pestalella/Borinot/README.md

# Borinot
Sensor de temperatura i humitat, que envia les dades que recull a una base de dades via WiFi
