pestalella/Borinot/Design/pcb_design.FCStd

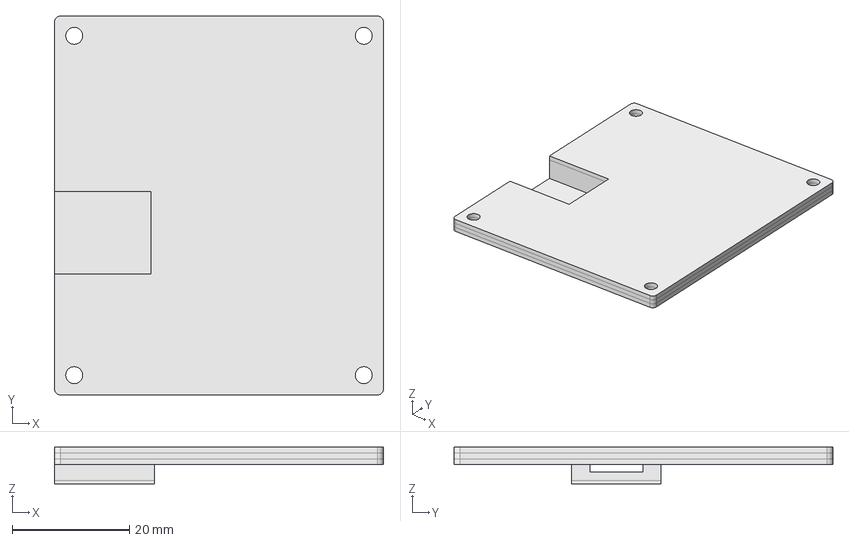
[picture p1: CAD file, 2023-03-15]
Design/pcb_design.FCStd
56.2 x 64.7 x 6.30 mm
