pestalella/Borinot/Design/pcb_design-Box.stl

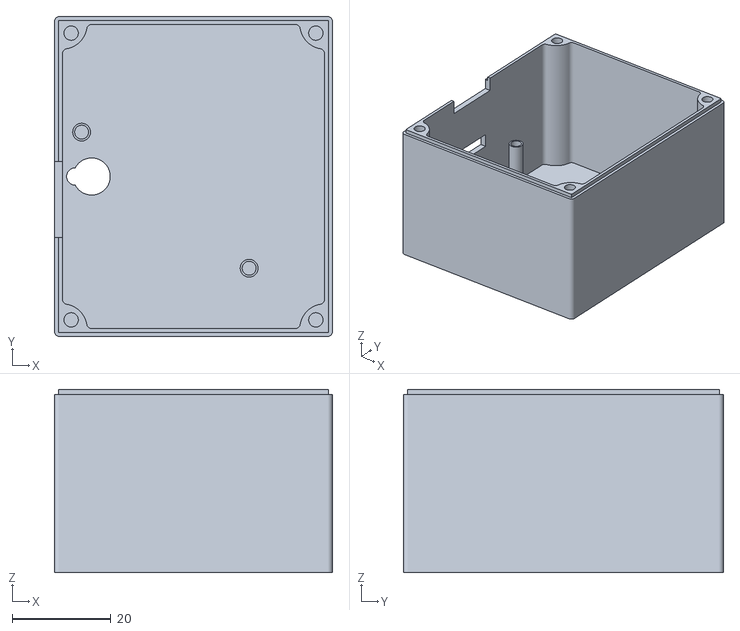
[picture p2: CAD file, 2023-03-15]
Design/pcb_design-Box.stl
56.2 x 64.7 x 37.0
