pestalella/Borinot/(list of files, cad)

Other CAD files:
Design/pcb_design-Lid.stl
