pestalella/Borinot/PCB/Borinot/Borinot.kicad_pcb

## KiCad design PCB/Borinot/Borinot.kicad_pcb (2023-05-26)

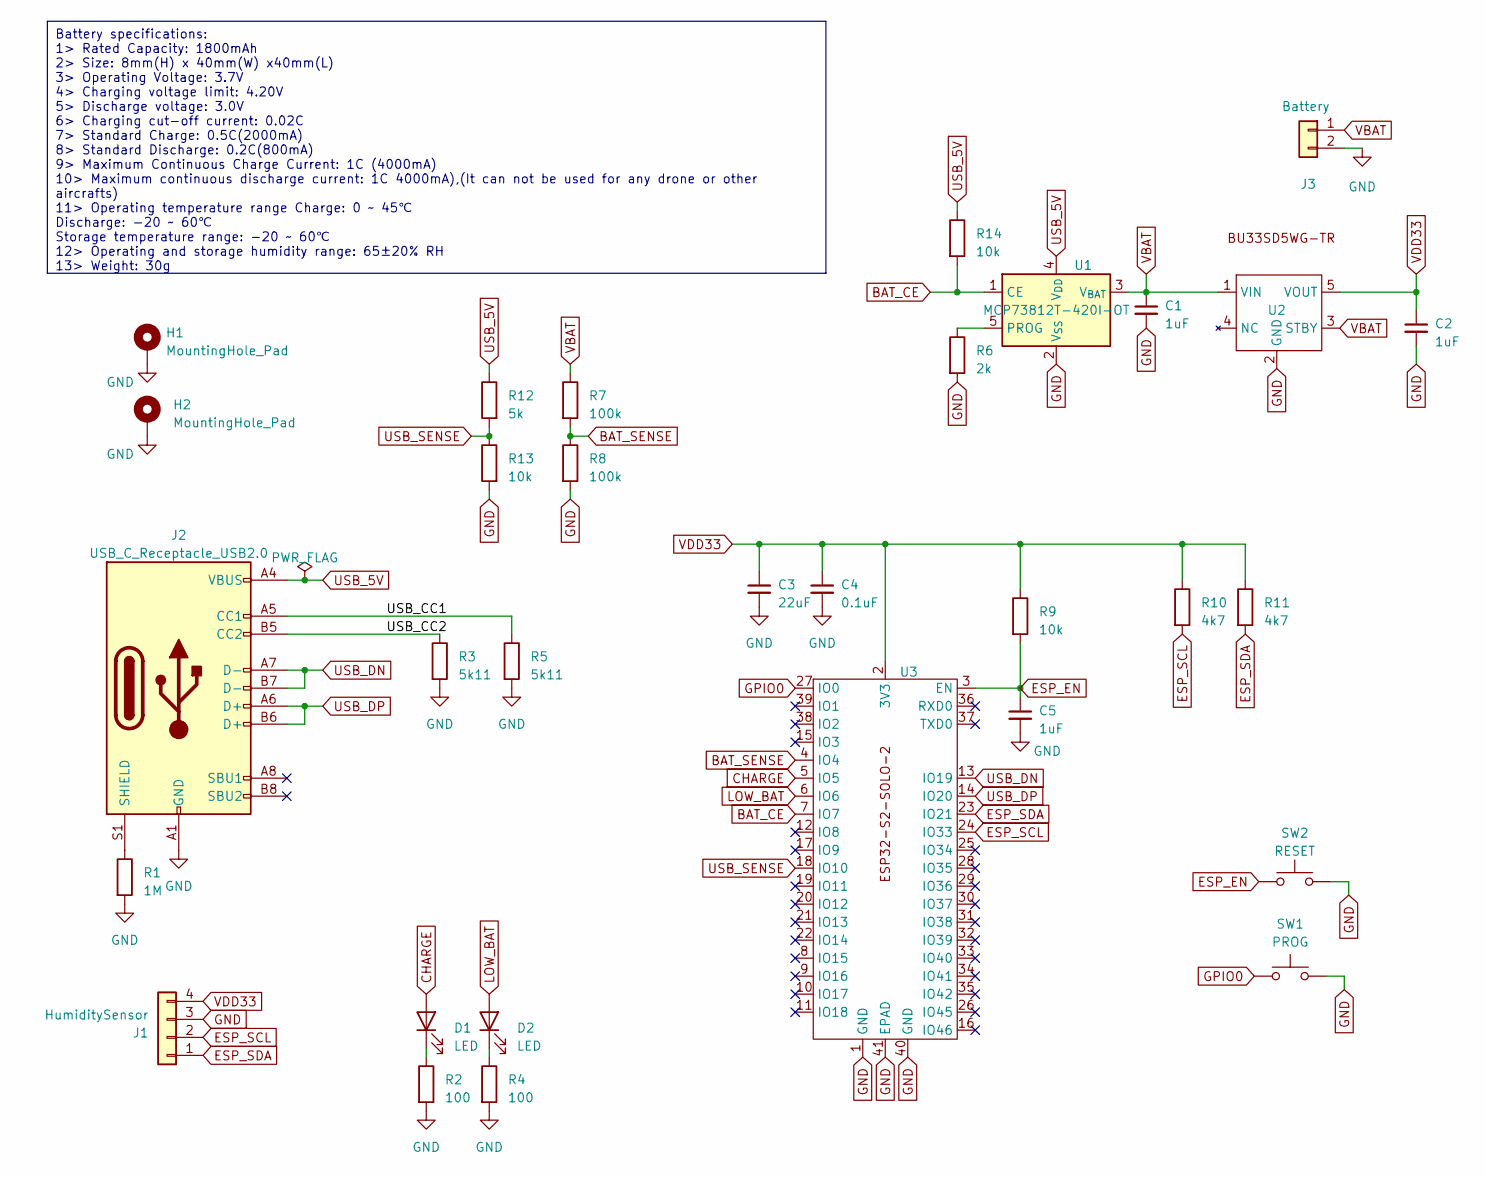
[picture p3: schematic Borinot.kicad_sch]

Parts:
C1, C2, C5: 1uF; C_0805_2012Metric_Pad1.18x1.45mm_HandSolder
C3: 22uF; C_0805_2012Metric_Pad1.18x1.45mm_HandSolder
C4: 0.1uF; C_0805_2012Metric_Pad1.18x1.45mm_HandSolder
D1, D2: LED; LED_0805_2012Metric
H1, H2: MountingHole_Pad; MountingHole_3.2mm_M3_Pad_Via
J1: HumiditySensor; Molex_KK-254_AE-6410-04A_1x04_P2.54mm_Vertical
J2: USB_C_Receptacle_USB2.0; USB_C_Receptacle_G-Switch_GT-USB-7010ASV
J3: Battery; PinHeader_1x02_P2.54mm_Vertical
R1: 1M; R_0805_2012Metric_Pad1.20x1.40mm_HandSolder
R2, R4: 100; R_0805_2012Metric_Pad1.20x1.40mm_HandSolder
R3, R5: 5k11; R_0805_2012Metric_Pad1.20x1.40mm_HandSolder
R6: 2k; R_0805_2012Metric_Pad1.20x1.40mm_HandSolder
R7, R8: 100k; R_0805_2012Metric_Pad1.20x1.40mm_HandSolder
R9, R13, R14: 10k; R_0805_2012Metric_Pad1.20x1.40mm_HandSolder
R10, R11: 4k7; R_0805_2012Metric_Pad1.20x1.40mm_HandSolder
R12: 5k; R_0805_2012Metric_Pad1.20x1.40mm_HandSolder
SW1: PROG; SW_PUSH_6mm
SW2: RESET; SW_PUSH_6mm
U1: MCP73812T-420I-OT; SOT-23-5
U2: SOT-23-5
U3: ESP32-S2-SOLO

Connections:
/USB_CC1: J2.A5 (CC1), R5.1
/USB_CC2: J2.B5 (CC2), R3.1
BAT_CE: R14.2, U1.1 (CE), U3.7 (IO7)
BAT_SENSE: R7.2, R8.1, U3.4 (IO4)
CHARGE: D1.2 (A), U3.5 (IO5)
ESP_EN: C5.1, R9.2, SW2.1, U3.3 (EN)
ESP_SCL: J1.2, R10.2, U3.24 (IO33)
ESP_SDA: J1.1, R11.2, U3.23 (IO21)
GND: C1.2, C2.2, C3.2, C4.2, C5.2, H1.1, H2.1, J1.3, J2.A1 (GND), J2.A12 (GND), J2.B1 (GND), J2.B12 (GND), J3.2, R1.2, R2.2, R3.2, R4.2, R5.2, R6.2, R8.2, R13.2, SW1.2, SW2.2, U1.2 (V_{SS}), U2.2 (GND), U3.1 (GND), U3.40 (GND), U3.41 (EPAD)
GPIO0: SW1.1, U3.27 (IO0)
LOW_BAT: D2.2 (A), U3.6 (IO6)
unnamed: D1.1 (K), R2.1
unnamed: D2.1 (K), R4.1
unnamed: J2.S1 (SHIELD), R1.1
unnamed: R6.1, U1.5 (PROG)
USB_5V: J2.A4 (VBUS), J2.A9 (VBUS), J2.B4 (VBUS), J2.B9 (VBUS), R12.1, R14.1, U1.4 (V_{DD})
USB_DN: J2.A7 (D-), J2.B7 (D-), U3.13 (IO19)
USB_DP: J2.A6 (D+), J2.B6 (D+), U3.14 (IO20)
USB_SENSE: R12.2, R13.1, U3.18 (IO10)
VBAT: C1.1, J3.1, R7.1, U1.3 (V_{BAT}), U2.1 (VIN), U2.3 (STBY)
VDD33: C2.1, C3.1, C4.1, J1.4, R9.1, R10.1, R11.1, U2.5 (VOUT), U3.2 (3V3)

Notes on the sheet:
Battery specifications: 1> Rated Capacity: 1800mAh 2> Size: 8mm(H) x 40mm(W) x40mm(L) 3> Operating Voltage: 3.7V 4> Charging voltage limit: 4.20V 5> Discharge voltage: 3.0V 6> Charging cut-off current: 0.02C 7> Standard Charge: 0.5C(2000mA) 8> Standard Discharge: 0.2C(800mA) 9> Maximum Continuous C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

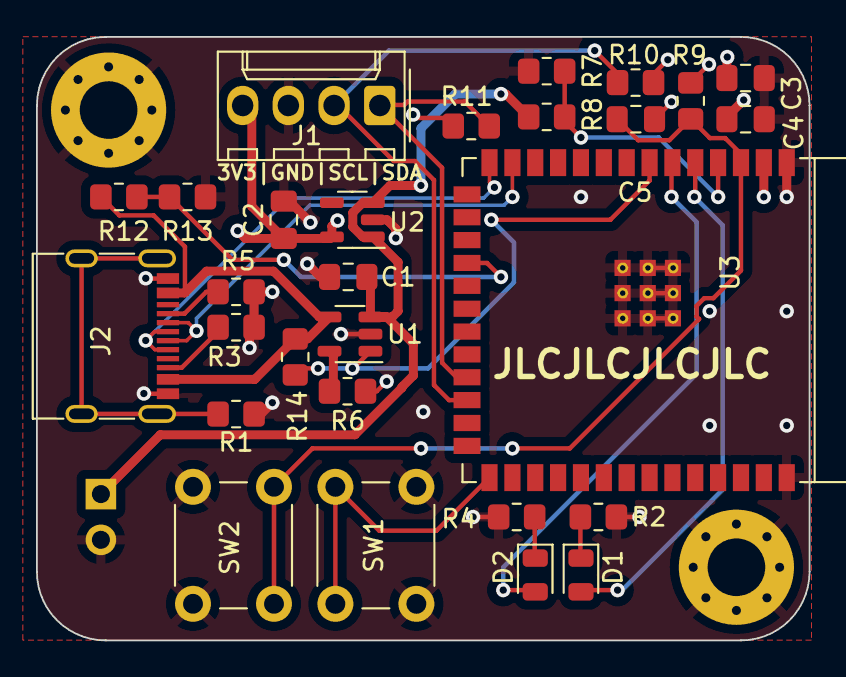
[picture p4: board Borinot.kicad_pcb from above]

Board: 4 copper layers, 42.9 x 33.5 mm, 31 parts (1 on the bottom side), 21 nets.
