pestalella/Borinot/(commit log)

2023-03-08 Initial import of PCB design
    Add Kicad PCB design files for the initial version
    of the PCB.
    [Borinot.kicad_pcb, Borinot.kicad_sch]
2023-03-08 Add project box design files
    Initial sketches of the pcb in FreeCAD to design a box to
    fit the pcb and the battery.
    [pcb_design.FCStd]
2023-03-10 Start constructing the box
    [pcb_design.FCStd]
2023-03-15 Finished project box
    First version of the project box, now ready to be printed.
    [pcb_design-Box.stl, pcb_design-Lid.stl, pcb_design.FCStd]
2023-04-26 Four-layer board
    Moved the design to a four-layer board, to simplify routing.
    [Borinot.kicad_pcb, Borinot.kicad_sch]
2023-05-02 Battery management change
    Use an easier-to-solder SOT-23-5-packaged battery manager
    to simplify the soldeering of the PCBs.
    [Borinot.kicad_pcb, Borinot.kicad_sch]
2023-05-25 Recover firmware for PCBs v0.2
2023-05-26 Add missing pull-up on ChargeEnable pin
    Without a pull-up to USB 5V on that pin it is impossible
    to start the ESP32 when the battery is below 3.3V
    Added a voltage divider to sense the 5V from USB and
    be able to decide whether to charge the battery or not.
    [Borinot.kicad_pcb, Borinot.kicad_sch]
